Faizul6/stm32-smart-soil-monitor/images/system-running-wet-condition.JPG

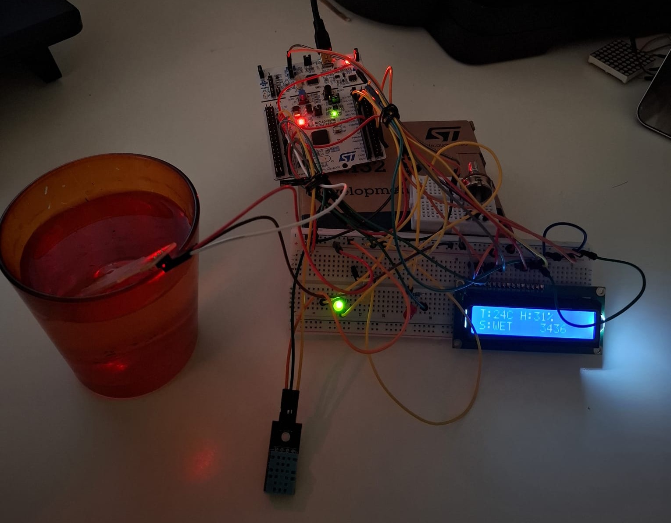
images/system-running-wet-condition.JPG
