Faizul6/stm32-smart-soil-monitor/Core/Src/main.c

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
/* Includes ------------------------------------------------------------------*/

#include "main.h"
#include <stdio.h>



/* USER CODE BEGIN PD */
#define DHT11_PORT GPIOA
#define DHT11_PIN  GPIO_PIN_1

#define LCD_RS_PORT GPIOB
#define LCD_RS_PIN  GPIO_PIN_0

#define LCD_E_PORT  GPIOB
#define LCD_E_PIN   GPIO_PIN_1

#define LCD_D4_PORT GPIOB
#define LCD_D4_PIN  GPIO_PIN_2

#define LCD_D5_PORT GPIOB
#define LCD_D5_PIN  GPIO_PIN_10

#define LCD_D6_PORT GPIOB
#define LCD_D6_PIN  GPIO_PIN_12

#define LCD_D7_PORT GPIOB
#define LCD_D7_PIN  GPIO_PIN_13
/* USER CODE END PD */

ADC_HandleTypeDef hadc1;

TIM_HandleTypeDef htim2;

UART_HandleTypeDef huart2;

/* USER CODE BEGIN PV */

uint8_t Rh_byte1, Rh_byte2, Temp_byte1, Temp_byte2;
uint16_t SUM;
uint8_t Presence = 0;

char lcd_line1[17];
char lcd_line2[17];

/* USER CODE END PV */

void SystemClock_Config(void);
static void MX_GPIO_Init(void);
static void MX_ADC1_Init(void);
static void MX_USART2_UART_Init(void);
static void MX_TIM2_Init(void);
/* USER CODE BEGIN PFP */
void Delay_us(uint16_t us);
void Set_Pin_Output(GPIO_TypeDef *GPIOx, uint16_t GPIO_Pin);
void Set_Pin_Input(GPIO_TypeDef *GPIOx, uint16_t GPIO_Pin);

void DHT11_Start(void);
uint8_t DHT11_Check_Response(void);
uint8_t DHT11_Read(void);

uint16_t Read_ADC_Value(void);
const char* Get_Soil_Status(uint16_t moisture);
void Update_Soil_LEDs(uint16_t moisture);

void LCD_PulseEnable(void);
void LCD_Write4Bits(uint8_t nibble);
void LCD_SendCommand(uint8_t cmd);
void LCD_SendData(uint8_t data);
void LCD_Init(void);
void LCD_Clear(void);
void LCD_SetCursor(uint8_t row, uint8_t col);
void LCD_SendString(char *str);
void LCD_PrintFixedLine(uint8_t row, char *text);
/* USER CODE END PFP */
/* USER CODE END 0 */

/* USER CODE END PFP */

/* USER CODE BEGIN 0 */

void Delay_us(uint16_t us)
{
    __HAL_TIM_SET_COUNTER(&htim2, 0);
    while (__HAL_TIM_GET_COUNTER(&htim2) < us);
}

void Set_Pin_Output(GPIO_TypeDef *GPIOx, uint16_t GPIO_Pin)
{
    GPIO_InitTypeDef GPIO_InitStruct = {0};
    GPIO_InitStruct.Pin = GPIO_Pin;
    GPIO_InitStruct.Mode = GPIO_MODE_OUTPUT_PP;
    GPIO_InitStruct.Pull = GPIO_NOPULL;
    GPIO_InitStruct.Speed = GPIO_SPEED_FREQ_LOW;
    HAL_GPIO_Init(GPIOx, &GPIO_InitStruct);
}

void Set_Pin_Input(GPIO_TypeDef *GPIOx, uint16_t GPIO_Pin)
{
    GPIO_InitTypeDef GPIO_InitStruct = {0};
    GPIO_InitStruct.Pin = GPIO_Pin;
    GPIO_InitStruct.Mode = GPIO_MODE_INPUT;
    GPIO_InitStruct.Pull = GPIO_PULLUP;
    HAL_GPIO_Init(GPIOx, &GPIO_InitStruct);
}

/* ---------------- DHT11 ---------------- */

void DHT11_Start(void)
{
    Set_Pin_Output(DHT11_PORT, DHT11_PIN);
    HAL_GPIO_WritePin(DHT11_PORT, DHT11_PIN, GPIO_PIN_RESET);
    HAL_Delay(20);
    HAL_GPIO_WritePin(DHT11_PORT, DHT11_PIN, GPIO_PIN_SET);
    Delay_us(40);
    Set_Pin_Input(DHT11_PORT, DHT11_PIN);
}

uint8_t DHT11_Check_Response(void)
{
    uint32_t timeout = 0;

    Delay_us(40);

    if (HAL_GPIO_ReadPin(DHT11_PORT, DHT11_PIN) == GPIO_PIN_RESET)
    {
        timeout = 0;
        while (HAL_GPIO_ReadPin(DHT11_PORT, DHT11_PIN) == GPIO_PIN_RESET)
        {
            Delay_us(1);
            if (++timeout > 100) return 0;
        }

        timeout = 0;
        while (HAL_GPIO_ReadPin(DHT11_PORT, DHT11_PIN) == GPIO_PIN_SET)
        {
            Delay_us(1);
            if (++timeout > 100) return 0;
        }

        return 1;
    }

    return 0;
}

uint8_t DHT11_Read(void)
{
    uint8_t i = 0;
    uint32_t timeout = 0;

    for (uint8_t j = 0; j < 8; j++)
    {
        timeout = 0;
        while (HAL_GPIO_ReadPin(DHT11_PORT, DHT11_PIN) == GPIO_PIN_RESET)
        {
            Delay_us(1);
            if (++timeout > 100) return 0;
        }

        Delay_us(30);

        if (HAL_GPIO_ReadPin(DHT11_PORT, DHT11_PIN) == GPIO_PIN_SET)
        {
            i |= (1 << (7 - j));
        }

        timeout = 0;
        while (HAL_GPIO_ReadPin(DHT11_PORT, DHT11_PIN) == GPIO_PIN_SET)
        {
            Delay_us(1);
            if (++timeout > 100) break;
        }
    }

    return i;
}

/* ---------------- ADC / Soil ---------------- */

uint16_t Read_ADC_Value(void)
{
    uint16_t adc_value = 0;

    HAL_ADC_Start(&hadc1);

    if (HAL_ADC_PollForConversion(&hadc1, 100) == HAL_OK)
    {
        adc_value = HAL_ADC_GetValue(&hadc1);
    }

    HAL_ADC_Stop(&hadc1);

    return adc_value;
}

/* Adapted from your working logic:
   moisture < 1500   -> DRY
   moisture < 2200   -> MEDIUM
   else              -> WET
*/
const char* Get_Soil_Status(uint16_t moisture)
{
    if (moisture < 1500)
    {
        return "DRY";
    }
    else if (moisture < 2200)
    {
        return "MEDIUM";
    }
    else
    {
        return "WET";
    }
}

void Update_Soil_LEDs(uint16_t moisture)
{
    HAL_GPIO_WritePin(GPIOA, GPIO_PIN_5, GPIO_PIN_RESET); // Green
    HAL_GPIO_WritePin(GPIOA, GPIO_PIN_6, GPIO_PIN_RESET); // Yellow
    HAL_GPIO_WritePin(GPIOA, GPIO_PIN_7, GPIO_PIN_RESET); // Red

    if (moisture < 1500)
    {
        HAL_GPIO_WritePin(GPIOA, GPIO_PIN_7, GPIO_PIN_SET); // Red
    }
    else if (moisture < 2200)
    {
        HAL_GPIO_WritePin(GPIOA, GPIO_PIN_6, GPIO_PIN_SET); // Yellow
    }
    else
    {
        HAL_GPIO_WritePin(GPIOA, GPIO_PIN_5, GPIO_PIN_SET); // Green
    }
}

/* ---------------- LCD ---------------- */

void LCD_PulseEnable(void)
{
    HAL_GPIO_WritePin(LCD_E_PORT, LCD_E_PIN, GPIO_PIN_SET);
    HAL_Delay(1);
    HAL_GPIO_WritePin(LCD_E_PORT, LCD_E_PIN, GPIO_PIN_RESET);
    HAL_Delay(1);
}

void LCD_Write4Bits(uint8_t nibble)
{
    HAL_GPIO_WritePin(LCD_D4_PORT, LCD_D4_PIN, (nibble & 0x01) ? GPIO_PIN_SET : GPIO_PIN_RESET);
    HAL_GPIO_WritePin(LCD_D5_PORT, LCD_D5_PIN, (nibble & 0x02) ? GPIO_PIN_SET : GPIO_PIN_RESET);
    HAL_GPIO_WritePin(LCD_D6_PORT, LCD_D6_PIN, (nibble & 0x04) ? GPIO_PIN_SET : GPIO_PIN_RESET);
    HAL_GPIO_WritePin(LCD_D7_PORT, LCD_D7_PIN, (nibble & 0x08) ? GPIO_PIN_SET : GPIO_PIN_RESET);

    LCD_PulseEnable();
}

void LCD_SendCommand(uint8_t cmd)
{
    HAL_GPIO_WritePin(LCD_RS_PORT, LCD_RS_PIN, GPIO_PIN_RESET);
    LCD_Write4Bits((cmd >> 4) & 0x0F);
    LCD_Write4Bits(cmd & 0x0F);
    HAL_Delay(2);
}

void LCD_SendData(uint8_t data)
{
    HAL_GPIO_WritePin(LCD_RS_PORT, LCD_RS_PIN, GPIO_PIN_SET);
    LCD_Write4Bits((data >> 4) & 0x0F);
    LCD_Write4Bits(data & 0x0F);
    HAL_Delay(2);
}

void LCD_Init(void)
{
    HAL_Delay(50);

    HAL_GPIO_WritePin(LCD_RS_PORT, LCD_RS_PIN, GPIO_PIN_RESET);
    HAL_GPIO_WritePin(LCD_E_PORT, LCD_E_PIN, GPIO_PIN_RESET);

    LCD_Write4Bits(0x03);
    HAL_Delay(5);
    LCD_Write4Bits(0x03);
    HAL_Delay(5);
    LCD_Write4Bits(0x03);
    HAL_Delay(5);
    LCD_Write4Bits(0x02);
    HAL_Delay(5);

    LCD_SendCommand(0x28); // 4-bit, 2-line
    LCD_SendCommand(0x08); // display off
    LCD_SendCommand(0x01); // clear
    HAL_Delay(3);
    LCD_SendCommand(0x06); // entry mode
    LCD_SendCommand(0x0C); // display on, cursor off
}

void LCD_Clear(void)
{
    LCD_SendCommand(0x01);
    HAL_Delay(3);
}

void LCD_SetCursor(uint8_t row, uint8_t col)
{
    uint8_t addr = (row == 0) ? (0x80 + col) : (0xC0 + col);
    LCD_SendCommand(addr);
}

void LCD_SendString(char *str)
{
    while (*str)
    {
        LCD_SendData(*str++);
    }
}

void LCD_PrintFixedLine(uint8_t row, char *text)
{
    char buffer[17];
    snprintf(buffer, sizeof(buffer), "%-16s", text);
    LCD_SetCursor(row, 0);
    LCD_SendString(buffer);
}


/* USER CODE END 0 */

/**
  * @brief  The application entry point.
  * @retval int
  */
int main(void)
{

  /* MCU Configuration--------------------------------------------------------*/

  /* Reset of all peripherals, Initializes the Flash interface and the Systick. */
  HAL_Init();

  /* Configure the system clock */
  SystemClock_Config();

  /* Initialize all configured peripherals */
  MX_GPIO_Init();
  MX_ADC1_Init();
  MX_USART2_UART_Init();
  MX_TIM2_Init();
  /* USER CODE BEGIN 2 */

  HAL_TIM_Base_Start(&htim2);

  LCD_Init();
  LCD_Clear();
  LCD_PrintFixedLine(0, "Smart Soil Test");
  LCD_PrintFixedLine(1, "Starting...");
  HAL_Delay(1500);

  /* USER CODE END 2 */

  /* Infinite loop */
  /* USER CODE BEGIN WHILE */
  while (1)
  {
          uint16_t moisture = Read_ADC_Value();
          const char *soil_status = Get_Soil_Status(moisture);
          uint8_t dht_ok = 0;

          DHT11_Start();
          Presence = DHT11_Check_Response();

          if (!Presence)
          {
              HAL_Delay(50);
              DHT11_Start();
              Presence = DHT11_Check_Response();
          }

          if (Presence)
          {
              Rh_byte1   = DHT11_Read();
              Rh_byte2   = DHT11_Read();
              Temp_byte1 = DHT11_Read();
              Temp_byte2 = DHT11_Read();
              SUM        = DHT11_Read();

              if (SUM == (Rh_byte1 + Rh_byte2 + Temp_byte1 + Temp_byte2))
              {
                  dht_ok = 1;
              }
          }

          Update_Soil_LEDs(moisture);

          if (dht_ok)
          {
              snprintf(lcd_line1, sizeof(lcd_line1), "T:%2dC H:%2d%%", Temp_byte1, Rh_byte1);
              snprintf(lcd_line2, sizeof(lcd_line2), "S:%-6s %4u", soil_status, moisture);

              printf("Temp: %d C | Humidity: %d %% | Moisture: %u | Status: %s\r\n",
                     Temp_byte1, Rh_byte1, moisture, soil_status);
          }
          else
          {
              snprintf(lcd_line1, sizeof(lcd_line1), "T/H Read Failed");
              snprintf(lcd_line2, sizeof(lcd_line2), "S:%-6s %4u", soil_status, moisture);

              printf("Temp/Humidity read failed | Moisture: %u | Status: %s\r\n",
                     moisture, soil_status);
          }

          LCD_PrintFixedLine(0, lcd_line1);
          LCD_PrintFixedLine(1, lcd_line2);

          HAL_Delay(3000);
      }
    /* USER CODE END 3 */
}

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
/* USER CODE BEGIN 4 */

int _write(int file, char *ptr, int len)
{
  (void)file;
  int DataIdx;

  for (DataIdx = 0; DataIdx < len; DataIdx++)
  {
    ITM_SendChar(*ptr++);
  }
  return len;
}

/* USER CODE END 4 */
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
